AngRelia/Fall-Detection-System/00-方案与计划.md

# 可穿戴跌倒与疲劳检测系统 — 实施方案与执行计划

> 课题：可穿戴跌倒与疲劳检测系统
> 对象：江彬锋（毕设作者）；我方负责方案设计、代码实现、实验编排与论文材料
> 版本：v1.0
> 编制日期：基于当前工作区与硬件实测现状

---

## 0. 一句话结论

题目要求完全可做，而且**起点比一般毕设好**：现成的自制 ICM-42688 + MMC5603 九轴板与已跑通的 Mahony 姿态融合工程可直接复用为"传感器节点"。真正的难点只有两个，方案已针对性解决：

1. **STM32F103C8T6 只有 64 KB Flash / 20 KB RAM**，剩余约 24 KB Flash，装不下 TensorFlow Lite Micro 官方运行时 → 改用 **int8 定点小型网络 + 自写推理内核 / STM32Cube.AI**。
2. **没有 4G 模块，但已有 GPS 模块** → 定位改由**设备端 DX-GP22-A（ATGM336H）自己采集**（资料与例程已入库 `GPS资料\`，驱动已落地 `Security Watch\MDK-ARM\icode\`），4G 仍由**手机中继**承担。这比原方案（定位交给手机）更贴近题面"跌倒事件上报并附带 GPS 位置"，详见 `docs/GPS模块接入方案.md`。

---

## 1. 现状盘点（均为实测，非推测）

### 1.1 已有硬件

| 物料 | 状态 | 说明 |
|---|---|---|
| STM32F103C8T6 × 2 及以上 | ✅ 有 | 双节点架构的基础 |
| 自制 IMU 板：ICM-42688-P(SPI) + MMC5603(I2C) | ✅ 有 | 六轴 + 磁力计 |
| BLE 串口模块 HC-08 | ✅ 有 | 透传 UART，BLE 4.0 |
| 蜂鸣器 / 按键 / 面包板 / 锂电池 | ✅ 有 | 告警与取消按钮所需的全部小件 |
| 4G + GPS 模块 | 🟡 半有 | GPS 已有 **DX-GP22-A / ATGM336H**（UART NMEA0183，资料在 `GPS资料\`）；4G 仍无，由手机中继替代 |

### 1.2 已有软件资产：`D:\STM32Project\ICM42688+MMC5603 9 axis gyroscope`

基于 STM32CubeMX + Keil MDK-ARM 5（AC5 编译器，`uAC6=0`），器件 `STM32F103C8`，FLASH 算法已配好可直接烧录。

已跑通并可直接复用的能力：

| 能力 | 实现位置 | 对本课题的价值 |
|---|---|---|
| ICM-42688 六轴驱动 + 零偏校准 | `MDK-ARM\icode\icm42688_driver.c` + `IMU_Calibrate()` | 传感器节点数据源，几乎零改动 |
| MMC5603 磁力计 + 硬铁偏移校准 | `MDK-ARM\icode\MMC5603.c` + `Mag_Calibrate()` | 可选增强（本课题非必需） |
| **Mahony 姿态融合（六轴/九轴可切换）** | `MDK-ARM\icode\MahonyAHRS.c` | 直接满足要求（1）"姿态角实时计算" |
| OLED 分页显示（5 页） | `MDK-ARM\icode\OLED.c` | 现场演示的调试界面 |
| 按键短按/长按 | `MDK-ARM\icode\key.c` | 可复用为"取消按钮"与模式切换 |
| Flash 读写校准参数 | `MDK-ARM\icode\my_flash.c` | 可复用为事件记录存储 |
| 串口打印 | `MDK-ARM\icode\Serial.c` | 改造为节点间协议与采集通道 |
| 1 kHz 定时中断采样源 | `TIM2` (PSC 719, ARR 999) | 采样节拍 |

> ⚠️ 注意：`资料包\` 内的两份示例工程是 **STM32F4** 的（`stm32f4xx_hal_conf.h`），只能当算法参考资料，不能直接编译到 F103。

### 1.3 当前固件资源占用（实测，来自 build log 与 map）

```
Program Size: Code=37190  RO-data=3762  RW-data=148  ZI-data=4772
Total RO  Size (Code + RO Data)          40952  (39.99 kB)   ← 占 Flash
Total RW  Size (RW Data + ZI Data)        4920  ( 4.80 kB)   ← 占 RAM
Total ROM Size (Code + RO Data + RW Data) 41100 (40.14 kB)
```

| 资源 | 总量 | 已用 | **可用余量** |
|---|---|---|---|
| Flash | 64 KB | 40.1 KB | **≈ 23.9 KB** |
| RAM | 20 KB | 4.8 KB | **≈ 15.2 KB** |

**这 23.9 KB / 15.2 KB 就是本课题全部新增功能的预算**（TinyML 模型 + 分类器 + 滤波 + BLE 驱动 + 告警逻辑）。

### 1.4 开发环境实测

| 组件 | 状态 |
|---|---|
| Keil MDK-ARM V5.36（`E:\Keil5\ARM`） | ✅ 已装，含 ST-Link 支持 |
| STM32CubeMX | ❌ 未安装（配置外设时需要） |
| STM32CubeProgrammer | ❌ 未安装（可用 Keil 内置下载替代） |
| STM32Cube.AI (X-CUBE-AI) 扩展包 | ❌ 未安装（若走 Cube.AI 路线需装） |
| Anaconda Python 3.13.5（`E:\anaconda3`） | ✅ 有 numpy / scipy / pandas / scikit-learn / matplotlib |
| TensorFlow / PyTorch | ❌ 未安装（训练时需要） |
| 本机外网（当前会话 shell） | ❌ 不通（TLS/DNS 均失败）→ 数据集与 pip 包需在你自己终端下载 |

---

## 2. 系统架构设计

### 2.1 双节点架构（充分利用 2 块 F103）

```
┌──────────────────────────────┐        UART 115200        ┌────────────────────────────────┐
│  节点 A：传感器节点 (F103)     │  ────────────────────▶   │  节点 B：主控节点 (F103)          │
│  · ICM-42688  1 kHz 采样(SPI) │   统一二进制帧 ~100 Hz    │  · 环形缓冲区 + 特征提取          │
│  · 滑动平均/低通滤波           │   (原始6轴 + 姿态角 + CRC) │  · TinyML int8 推理 → 跌倒判定    │
│  · Mahony 融合 → Roll/Pitch/Yaw│                          │  · 疲劳判定（方差 + 步态周期）    │
│  · 打包 + 校验 + 发送          │                          │  · 两阶段确认 → 蜂鸣告警          │
│  · OLED 状态显示              │                          │  · 取消按钮（防误报）             │
└──────────────────────────────┘                          │  · HC-08 BLE → 手机              │
                                                          └────────────────┬───────────────┘
                                                                           │ BLE (UART 透传)
                                                                           ▼
                                                          ┌────────────────────────────────┐
                                                          │  手机 App（中继网关）            │
                                                          │  · 接收告警 + 读取本机 GPS        │
                                                          │  · 4G/WiFi → 上报云端            │
                                                          └────────────────┬───────────────┘
                                                                           │ HTTPS / MQTT
                                                                           ▼
                                                          ┌────────────────────────────────┐
                                                          │  云端（服务器/本地均可）          │
                                                          │  · 事件入库   · 推送告警          │
                                                          │  · Web 可视化大屏（地图 + 曲线）   │
                                                          └────────────────────────────────┘
```

**为什么把姿态解算放在节点 A：** F103 无 FPU，Mahony 属于浮点密集运算。把它留在已有工程里（已在跑、已验证），节点 B 就能把全部算力和 24 KB Flash 余量留给 TinyML 与告警逻辑。这是本方案能同时满足要求（1）和（2）的关键。

**串口参数必须改：** 当前 `USART2` 波特率为 **9600**，传不动 100 Hz × 6 维 float。节点间链路改为 **115200**（`Serial.c` 中已按 115200 初始化，需与 `MX_USART2_UART_Init` 对齐）。

### 2.2 节点间帧协议（v1，定长 32 字节，小端）

| 偏移 | 长度 | 字段 | 类型 | 说明 |
|---|---|---|---|---|
| 0 | 2 | header | uint16 | 0xAA55，帧同步头 |
| 2 | 1 | type | uint8 | 0x01=IMU 数据帧 |
| 3 | 1 | seq | uint8 | 序号，用于丢包统计 |
| 4 | 4 | timestamp_ms | uint32 | 节点 A 时间戳 |
| 8 | 6 | acc[3] | int16 ×3 | 加速度，单位 mg（±16 g 量程） |
| 14 | 6 | gyro[3] | int16 ×3 | 角速度，单位 0.1 °/s（±2000 °/s） |
| 20 | 6 | rpy[3] | int16 ×3 | Roll/Pitch/Yaw，单位 0.01° |
| 26 | 4 | reserved | uint32 | 预留（磁力计/状态位） |
| 30 | 2 | crc16 | uint16 | CRC-16/MODBUS，覆盖 2~29 字节 |

> 100 Hz × 32 B = 3.2 KB/s，115200 bps（≈11.5 KB/s）余量充足。
> 定点整数传递而非 ASCII 浮点，是为了让节点 B 拿到**无精度损失**的原始量，同时省掉解析开销。

### 2.3 节点间电气连接

| 节点 A | 节点 B | 备注 |
|---|---|---|
| PA2 (USART2_TX) | PA3 (USART2_RX) | 交叉连接 |
| PA3 (USART2_RX) | PA2 (USART2_TX) | 可选，反向命令通道 |
| GND | GND | **必须共地** |

节点 B 另接：HC-08（另一路 UART，例如 USART1 PA9/PA10）、蜂鸣器（有源，GPIO 或 TIM PWM）、取消按钮（GPIO 上拉 + 中断）。

---

## 3. 五项设计要求的落地方案

### 要求（1）三轴加速度计 + 陀螺仪数据融合，实时计算姿态角

- **直接复用已跑通的 Mahony 融合**（`MahonyAHRS.c`），六轴模式（加速度计 + 陀螺仪）即满足题面。
- 磁力计 MMC5603 作为**可选增强**：论文中可作为"九轴对比实验"，但佩戴式跌倒检测场景磁干扰大，**主方案用六轴**，避免引入不稳定性。
- 需做的工程化改进：
  - 采样率从 1 kHz 降到 **200 Hz 融合 / 100 Hz 输出**（F103 无 FPU，1 kHz 浮点 Mahony 会吃满 CPU）；
  - 增加一阶低通（加速度计 α≈0.2，陀螺仪 α≈0.5）抑制佩戴抖动；
  - 保留 `IMU_Calibrate()` 上电零偏校准流程，并把校准结果写入 Flash。

### 要求（2）TinyML 轻量级模型在 MCU 端运行跌倒检测推理 ★核心难点

**路线决策（关键）：**

| 方案 | Flash 占用 | 可行性 | 结论 |
|---|---|---|---|
| TensorFlow Lite Micro 官方运行时 + 任意模型 | 60–100 KB（仅内核） | ❌ | 超出 23.9 KB 预算，**排除** |
| **STM32Cube.AI (X-CUBE-AI) 生成代码 + int8 MLP** | 4–12 KB | ✅ | **主路线**，论文表述规范 |
| **自写 int8 定点推理内核 + PC 端手动量化** | 2–6 KB | ✅ | **保底路线**，零额外工具依赖 |
| 纯阈值/决策树（无 NN） | <1 KB | ✅ | 只作对照实验，不单用 |

**选定：主路线 = STM32Cube.AI，保底 = 自写定点内核。** 两条路线共用同一个训练产物（int8 量化权重），可互相验证，论文里还能写成"两种部署方案对比"，是加分项。

**模型设计（面向 24 KB 预算反推）：**

- 输入：滑动窗口 **2 s @ 100 Hz = 200 采样点**，6 通道（ax, ay, az, gx, gy, gz）
- 结构：`Conv1D(8, k=5, s=2) → ReLU → MaxPool(2) → Conv1D(16, k=3) → ReLU → GlobalAvgPool → Dense(16) → ReLU → Dense(3)`
- 输出 3 类：`ADL（日常活动）/ Fall（跌倒）/ Near-fall（近似跌倒）`
- 参数量目标 **< 3000**，全 int8 量化后权重约 **3 KB**，激活值峰值约 **4 KB RAM**
- 两阶段判定（工程上极其重要，直接影响误报率）：
  1. **阈值预筛**：`|a| > 2.5 g` 或 `|Δ角度| > 60°/s` 的突变才触发；
  2. **NN 确认**：对触发点前 2 s 窗口跑一次推理，输出 Fall 且置信度 > 0.8 才告警。

**训练数据：** 以公开数据集为主（见 §5），自采数据做校准/微调。

### 要求（3）疲劳状态判定（基于运动幅度方差与步态周期分析）

完全按题面两条指标实现，另加一条增强项：

| 指标 | 计算方法 | 判定含义 |
|---|---|---|
| **运动幅度方差** | 加速度模值 `|a| = √(ax²+ay²+az²)` 去重力后，4 s 窗口方差 `σ²` | σ² 过低 → 久坐/静止；异常波动 → 动作失控 |
| **步态周期** | 对去重力后的竖直轴做峰值检测求步频 `f_step`；对自相关函数取主峰求周期 `T_gait` | 步频偏离个人基线 ±20% → 步态异常 |
| **步态变异系数（增强）** | `CV = std(T_gait) / mean(T_gait)`，逐周期统计 | CV 升高是公认的疲劳/步态不稳标志 |

- 输出三级状态：`正常 / 轻度疲劳 / 显著疲劳`，用加权评分 + 阈值给出，阈值通过个人基线自校准（上电静立 10 s 建立基线）。
- **在 PC 端用同算法离线跑一遍公开数据集**，画出方差/步频随疲劳变化曲线，作为论文的算法验证章节。
- **MCU 端资源优化**：方差用滑动和增量更新（O(1)），不做 FFT；自相关限制在 lag ∈ [0.5 s, 2.0 s]（步频 0.5–2 Hz），只算 150 个 lag，节点 B 完全放得下。

### 要求（4）跌倒事件通过 BLE/4G 上报云端，附带 GPS 位置

- **BLE 段（MCU）**：HC-08 通过第二路 UART 接节点 B，用 AT 指令配置（名称/波特率），透传上报 JSON 精简报文：
  ```json
  {"t":1712345678,"dev":"JBX-01","ev":"FALL","conf":0.93,
   "acc":[1.2,-2.8,3.9],"rpy":[82.1,-15.3,7.6],"step":98,"seq":4521}
  ```
- **GPS 段（设备端，已升级）**：主控节点 B 直接接 **DX-GP22-A（ATGM336H）**，用一路 UART 收 NMEA0183（默认 9600 8N1），解析出经纬度/定位质量/卫星数/HDOP/海拔，缓存为"最新定位快照"。跌倒确认时把位置片段拼进告警报文（标度为定点整数，见 `docs/GPS模块接入方案.md`）。
  - 室内/无星时**不阻塞告警**：报文里带 `v=0` 与 `fix_age`（最后已知位置距今毫秒数），云端据此提示"位置可能已过时"。这是真实可穿戴产品的通行做法，也是论文里的设计取舍点。
  - 手机中继仍然保留，但只承担 4G/WiFi 上云；**手机定位降级为交叉校验/兜底**，不再作为主定位源。
  - 已落地代码：`Security Watch\MDK-ARM\icode\driver\gps.c/h`（NMEA 解析、整数定点、seqlock 快照、$PCA 配置）+ `icode\task\gps_task.c/h`（接收与健康检查任务）。
  - ⚠ 硬件注意：底板 **VDD 需 3.6~6 V（典型 5 V）**，不能用 3.3 V 直供；接地必须共地；TX/RX 交叉；VBAT 接 3 V 备电可保住热启动。
- **4G 段（手机）**：手机 App 用 4G/WiFi 上报。**答辩现场推荐用本机后端**（笔记本开热点 + Node.js 服务），规避现场公网/流量问题；同时保留一个公网 MQTT 配置作为备选。
- **云端**：`Node.js (Express + ws) + SQLite`，提供
  - `POST /api/events` 接收事件
  - `GET /api/events` 查询历史
  - WebSocket 实时推送
  - **Web 可视化页面**：Leaflet 地图打点 + 加速度/姿态曲线回放（答辩最出效果的部分）
- **⚠️ HC-08 的限制（必须提前知道）**：HC-08 是 CC2541 私有透传固件，**不是标准 BLE 串口 GATT 服务**，第三方 App 无法直接连接，官方"汇承 HC-08"App 是闭源且功能受限。
  - 应对 A（推荐）：Node B → HC-08 → 手机官方 App 收到数据，**再手工/脚本转发**到云端。演示链路完整，但手机端非自研。
  - 应对 B：换 **JDY-31 / AT-09 / HM-10 克隆版**（几十元），标准 GATT，可配 MIT App Inventor 或 Flutter 写自研 App，论文中"移动端"章节才立得住。
  - 应对 C：手机端改用 **Serial Bluetooth Terminal + HTTP 转发宏**，或直接用笔记本蓝牙串口接收，把"手机 App"降级为可选。
  - → **建议：先按 A 做通链路，中期后再决定是否补一个标准 GATT 模块（约 20 元）把移动端做实。**

### 要求（5）本地蜂鸣告警与取消按钮（防误报）

**状态机（这是防误报的核心，论文里可以单独成节）：**

```
IDLE ──(NN 判定 Fall)──▶ PENDING 蜂鸣器 1 Hz 间歇鸣叫
                            │
                            ├─(20 s 内按下取消按钮)──▶ CANCELLED 记录误报样本，加入再训练集
                            │
                            └─(20 s 超时未取消)──────▶ CONFIRMED 长鸣 3 s + BLE 上报云端
                                                          │
                                                          └─(120 s 冷却)──▶ IDLE
```

- 取消窗口 **20 s**、告警冷却 **120 s**，两者都做成宏便于调参。
- 取消按钮复用现有 `key.c` 的按键驱动（短按/长按识别已实现）。
- 蜂鸣器：有源蜂鸣器 + NPN 三极管驱动（GPIO 即可），或直接用带驱动板的模块。
- **被取消的事件不入库为"跌倒"，但入"误报库"**——这批数据是论文里分析误报来源、做阈值调优的宝贵素材。

---

## 4. 工作量分解与里程碑（16 周计划）

### 阶段划分

| 阶段 | 周次 | 目标 | 交付物 | 验收标准 |
|---|---|---|---|---|
| **P0 打通链路** | W1–2 | 节点 A 高速输出 + 节点 B 接收 | `firmware/node_a`、`firmware/node_b` 可编译固件 | 节点 B 串口/OLED 稳定显示 100 Hz 数据，CRC 零错误，连续跑 30 min 不丢帧 |
| **P1 数据与算法** | W3–6 | 数据集 + PC 端算法形成结论 | `tools/dataset`、`tools/train` 脚本与报告 | 公开数据集上 PC 端分类 F1 > 0.9；疲劳曲线可复现 |
| **P2 模型上板** | W7–9 | TinyML 真正跑在 MCU | `firmware/node_b/ml/`（权重 C 文件 + 推理内核）+ Flash/RAM 实测表 | 单次推理 < 20 ms，Flash 总占用 < 60 KB，跌倒判定在线可用 |
| **P3 告警与云端** | W10–12 | 端到端闭环 | 告警状态机 + 手机中继 + 云端服务 + Web 大屏 | 跌倒 → 蜂鸣 → 取消/上报 → 云端可见 → 地图打点，全链路演示成功 |
| **P4 评测与论文** | W13–16 | 实验数据 + 论文 | 性能评测报告、论文初稿、答辩 PPT、演示视频 | 混淆矩阵/F1、延迟、功耗、误报率四项数据齐全 |

### 详细任务清单

**P0（W1–2）打通链路**
- [ ] 建 `firmware/node_a`：复制现有工程，删掉 OLED 五页显示中与课题无关的部分
- [ ] `USART2` 波特率 9600 → **115200**
- [ ] 采样率 1 kHz → 200 Hz 融合、100 Hz 输出；加速度/陀螺加一阶低通
- [ ] 实现帧打包 + CRC-16 + 发送（`proto.c/h`）
- [ ] 建 `firmware/node_b`：串口 DMA 空闲中断接收 + 环形缓冲 + 帧解析
- [ ] OLED 显示帧率/丢帧数/校验错误数（现场调试用）
- [ ] 写 `tools/serial_logger.py`（pyserial）：串口 → CSV，为 P1 采集做准备

**P1（W3–6）数据与算法**
- [ ] 获取公开数据集（见 §5），统一为 `[样本, 时间, 通道]` 的 npz/npy
- [ ] 重采样到 100 Hz、滑窗切分（2 s 窗 / 50% 重叠）、类别平衡
- [ ] PC 端实现姿态融合与疲劳指标算法（Python 版，作为 MCU 端参考实现 + 论文图表来源）
- [ ] 训练基准模型（先用 scikit-learn MLPClassifier 跑通全流程，再上 TensorFlow）
- [ ] 输出：混淆矩阵、F1、ROC；疲劳方差/步频分析图

**P2（W7–9）模型上板**
- [ ] int8 训练后量化（PTQ），导出权重
- [ ] 路线一：安装 STM32CubeMX + X-CUBE-AI，生成 C 代码
- [ ] 路线二：`tools/export` 脚本生成 `ml_weights.c/h` + 自写 int8 内核（含 CMSIS-NN 选项）
- [ ] 两条路线精度与资源对比（论文加分点）
- [ ] 在线推理接入两阶段判定；实测推理耗时与 Flash/RAM 占用

**P3（W10–12）告警与云端**
- [ ] 蜂鸣告警状态机 + 取消按钮 + 冷却逻辑
- [ ] HC-08 AT 配置 + BLE 上报协议
- [ ] 手机中继（官方 App 或自研 App，含 GPS 读取）
- [ ] `cloud/` ：Node.js + SQLite + WebSocket + Web 大屏（Leaflet 地图 + 曲线）
- [ ] 端到端联调，含断连重传与本地缓存补传

**P4（W13–16）评测与论文**
- [ ] 实验：不同受试者/佩戴位置/动作强度的跌倒检测性能
- [ ] 实验：单次推理延迟、端到端告警延迟、整机电流与续航估算
- [ ] 实验：误报率统计 + 取消按钮有效性
- [ ] 对比实验：纯阈值 vs TinyML vs 阈值+NN 两阶段
- [ ] 论文正文、图表、答辩 PPT、演示视频、使用说明

### 关键路径与风险

```
P0 链路 ──▶ P1 数据/算法 ──▶ P2 模型上板 ──▶ P3 端到端 ──▶ P4 论文
   ▲              ▲                ▲
   └ 若 115200 不稳 │ 若数据集不匹配   │ 若 24 KB 装不下 → 触发降级策略
```

| 风险 | 概率 | 影响 | 应对 |
|---|---|---|---|
| 24 KB Flash 装不下模型 | 中 | 高 | 缩窗口到 1 s、通道减到 3（仅加速度计）、通道剪枝；极端情况降到决策树 + 特征工程 |
| 公开数据集与自制 IMU 不匹配 | 高 | 中 | 统一重采样 + 归一化 + 自采少量数据微调（迁移学习思路） |
| HC-08 无法对接自研 App | 高 | 中 | 见 §3(4) 应对 A/B/C，中期前决策 |
| 双节点联调耗时超预期 | 中 | 中 | P0 阶段就做 30 min 长稳测试，不等后期 |
| F103 CPU 被浮点算力拖垮 | 中 | 中 | 姿态解算留在节点 A；节点 B 全定点 int8；关键路径实测耗时 |

---

## 5. 数据集方案（重点：以前没用过）

**先说方法：** 不要试图找"和本课题一模一样"的数据集，不存在。正确做法是找**同类型传感器（三轴加速度计 + 三轴陀螺仪）、佩戴在腰部/腕部、含跌倒与日常活动标注**的公开数据集，统一重采样到 100 Hz 后使用。

### 推荐数据集（按优先级）

| 数据集 | 内容 | 采样率 | 传感器位置 | 备注 |
|---|---|---|---|---|
| **SisFall** ⭐首选 | 19 种 ADL + 15 种跌倒，38 名受试者（含老年人） | 200 Hz | 腰部 | 规模最大、最规范，跌倒检测论文的标准基线 |
| **UMAFall** | 3 种跌倒 + 12 种 ADL，含多传感器位置 | 200 Hz | 腰/胸/腕/踝 | 有助做"佩戴位置对比"实验 |
| **MobiFall** | 含跌倒 + 日常，手机内置 IMU | 87 Hz | 裤袋 | 可作迁移性验证 |
| **FallAllD** | 多种设备、多位置，大数据量 | 238 Hz | 多位置 | 替代/补充 |
| **WISDM / PAMAP2** | 日常活动识别（走路/跑步/久坐） | 20 / 100 Hz | 腕/多位置 | **用于疲劳判定的"活动强度"参考** |

**SisFall 获取：** 官网 `www.sisale.pt`（你本机可访问，我的会话 shell 不通外网）。另可直接搜索 "SisFall dataset download"，多数高校镜像与 Kaggle 有副本。

### 统一处理流程

```
下载原始数据 → 解析为统一格式 → 重采样到 100 Hz（scipy.signal.resample_poly）
  → 去重力（Butterworth 0.3 Hz 高通）→ 分通道归一化（按 g 为单位）
  → 滑窗切分 2 s / 50% 重叠 → 类别平衡（SMOTE 或加权损失）
  → 训练 / 验证 / 测试按"受试者"划分（LEAVE-SUBJECT-OUT，防数据泄漏）
```

> ⚠️ **绝不能按时间随机划分**——同一受试者的相邻窗口同时进训练集和测试集会导致指标虚高，这是评审常见的质疑点，必须在论文里写明按受试者划分。

### 自采数据（做微调，不是主力）

- **安全性第一**：跌倒在**厚床垫/体操垫**上，佩戴护具；先低速慢动作演练，确认设备不掉、不伤。
- 采集协议：5 名受试者 ×（模拟跌倒 3 类 × 10 次 + ADL 6 类 × 各 2 min）。
- 用 `tools/serial_logger.py` 直接把节点 A 串口流存成 CSV，自带时间戳与动作标签（按键打标）。
- 自采数据用途：① 验证公开数据集训练的模型在自制 IMU 上的迁移效果；② 论文中做数据增强与微调的论据。

### 训练环境建议

当前 Anaconda 是 **Python 3.13**，TensorFlow 尚无对应轮子。二选一：

- **方案甲（推荐）**：新建环境 `conda create -n fall python=3.10 && pip install tensorflow==2.15 scikit-learn scipy pandas matplotlib`
- **方案乙（零安装）**：沿用现有 scikit-learn 的 `MLPClassifier` 跑通全流程，手动做 int8 量化。**我已验证本机现装环境可用**，可作为网络不通时的保底路径。

---

## 6. 目录结构与交付物

```
江彬锋的毕设/
├── 00-方案与计划.md                  ← 本文档
├── 01-开题与需求分析.md               （待产出）
├── firmware/
│   ├── node_a_sensor/               传感器节点（基于现有工程改造）
│   │   ├── Core/                    含修改后的 main.c、usart.c
│   │   ├── icode/                   icm42688_driver, MahonyAHRS, OLED, key, Serial
│   │   ├── proto/                   帧协议：打包 / CRC16
│   │   └── MDK-ARM/                 Keil 工程
│   └── node_b_main/                 主控节点（新建）
│       ├── Core/                    串口 DMA 接收、定时器、GPIO
│       ├── app/                     环形缓冲、特征提取、疲劳判定、告警状态机
│       ├── ml/                      ml_weights.c/h + int8 推理内核
│       ├── drv/                     hc08 (BLE)、buzzer、button
│       └── MDK-ARM/                 Keil 工程
├── tools/
│   ├── serial_logger.py             串口 → CSV 采集
│   ├── dataset/                     公开数据集下载、解析、统一重采样
│   ├── train/                       特征工程、训练、量化、评估
│   ├── export/                      权重 → C 数组 / Cube.AI 调用
│   └── analysis/                    论文图表生成（混淆矩阵、方差/步频曲线）
├── cloud/
│   ├── server/                      Node.js + SQLite + WebSocket
│   └── web/                         Leaflet 地图 + 曲线大屏
├── mobile/                          手机中继（App 或脚本）
├── docs/
│   ├── 硬件连接与元件清单.md
│   ├── 帧协议与接口说明.md
│   ├── 实验记录.md
│   ├── 复现与演示步骤.md
│   ├── GPS模块接入方案.md          GPS 驱动/UART 分配/验证分级/实测记录
│   ├── 按键接线与引脚分配.md       4 个按键接线、事件 API、屏幕切换
│   └── OLED显示指标说明.md         **屏幕上每个指标的含义与异常判读（速查）**
├── thesis/                          论文正文、图表、答辩 PPT
└── data/
    ├── raw/                         原始公开数据集（大文件，注意管理）
    ├── processed/                   npz
    └── self_collected/              自采 CSV
```

### 我方可交付的具体成果

1. **两套可编译的 Keil 固件工程**（节点 A 改造版 + 节点 B 新建），每个里程碑都能编译烧录验证。
2. **训练与量化脚本**：从数据集到 `ml_weights.c` 一键流水线。
3. **自写 int8 定点推理内核**（不依赖 TFLite Micro，专为 F103 的 24 KB 余量设计）。
4. **云端服务 + Web 可视化大屏**：地图打点 + 曲线回放。
5. **手机中继**：含 GPS 读取与上报。
6. **全部论文素材**：算法原理推导、资源占用实测表、混淆矩阵、性能对比图、实验记录。

---

## 7. 需要新增的元件清单

| 元件 | 数量 | 约价 | 必需性 | 说明 |
|---|---|---|---|---|
| 有源蜂鸣器 + NPN 三极管/模块 | 1 | 3–5 元 | ✅ 必需 | 告警输出（若已有带驱动板的模块可直接用） |
| 杜邦线（公母）、面包板 | 若干 | 已有 | ✅ 必需 | 双节点互联 |
| 锂电池 + 充电/升压模块 | 1 | 20–30 元 | 建议 | 做成"可穿戴"形态，答辩必备 |
| 标准 BLE 串口模块（JDY-31/AT-09） | 1 | ~20 元 | 建议 | 若要做自研移动端 App 则必需 |
| USB-TTL 串口模块 | 1 | ~10 元 | 建议 | 调试与数据采集 |
| ST-Link V2 | 1 | 已有 | ✅ 必需 | 烧录 |
| DX-GP22-A GNSS 模块 | 1 | 已有 | ✅ 必需 | 资料已入库 `GPS资料\`；底板要 **5 V** 供电 |
| CR2032 + 电池座（接 GPS VBAT） | 1 | ~3 元 | 建议 | 保住备电 → 上电热启动，TTFF 从 30 s+ 降到数秒 |

> 唯一硬性缺口是**有源蜂鸣器**，其余都有或可选。

---

## 8. 待确认的决策点

| # | 决策 | 选项 | 建议 | 影响 |
|---|---|---|---|---|
| D1 | TinyML 部署路线 | A: Cube.AI / B: 自写内核 / C: 两条都做 | **C（先 B 保底，再 A 正规化）** | 论文可写"两种部署方案对比" |
| D2 | 移动端方案 | A: HC-08 + 官方 App / B: 换标准 GATT 模块自研 App / C: 手机降级为可选 | **先 A，中期前定 B** | 决定论文"移动端"章节的成色 |
| D3 | 云端部署形态 | A: 本机服务（答辩稳） / B: 公网 MQTT / C: 都配 | **C** | 现场演示风险 |
| D4 | 疲劳判定是否加心率 | 加 MAX30102 血氧/心率（~15 元） | **暂不加** | 题面未要求，加了会摊薄工作量 |
| D5 | 佩戴位置 | 腰部 / 腕部 / 胸部 | **腰部**（公开数据集最匹配，跌倒特征最显著） | 影响数据集选择与硬件形态 |
| D6 | GPS 挂在哪块板 | A: 主控节点 B 直挂（需把 KEY_3/KEY_4 让出 PA2/PA3）/ B: 传感器节点 A 挂 GPS + 扩帧转发 | **A**（改动只在一个工程里，位置数据直通告警报文） | 决定 UART/引脚分配与是否需要改接线 |

---

## 9. 下一步立即行动（本周可启动）

按优先级，前 5 项不需要任何新增硬件：

1. **立项与目录初始化**：建 §6 的目录骨架，把现有 IMU 工程复制为 `firmware/node_a_sensor` 的起点（原工程保持不动，作为回退）。
2. **节点 A 改造**：波特率改 115200、采样率改 200 Hz 融合/100 Hz 输出、加低通滤波、实现 32 字节帧协议 + CRC-16。目标：串口能稳定吐 100 Hz 定长帧。
3. **节点 B 骨架**：串口 DMA + 空闲中断接收、环形缓冲、帧解析、OLED 显示帧率与丢帧率。目标：连续 30 min 零丢帧。
4. **采集工具**：写 `tools/serial_logger.py`（pyserial → CSV，支持按键打标），立刻开始积累自采数据。
5. **数据集准备**：下载 SisFall（你本机可通外网），写解析与统一重采样脚本。同时用现有 scikit-learn 环境把"特征 → 训练 → 评估"全流程先跑通一遍。
6. **环境补齐**（可与上面并行）：安装 STM32CubeMX；建 Python 3.10 环境装 TensorFlow；决定是否需要 Cube.AI。
7. **GPS 模块台架验证**（不需要焊接，先做）：用 USB-TTL + `sscom5.13.1`（资料包内）以 9600 8N1 接模块 TXD/RXD，确认能收到 `$GNRMC/$GNGGA`；再用 `$PCAS03` 精简输出语句、`$PCAS10,0` 热启动。通过后再按 `docs/GPS模块接入方案.md` 第 4 节把模块接到主控节点 B。

---

## 10. 附：环境与工程实测记录

**通用环境**

```
工作区目录权限   ：原缺 WRITE_OWNER，已修复（备份于 C:\Users\wcx12\.dsh\acl-recovery\）
Keil MDK-ARM     ：V5.36 @ E:\Keil5\ARM，编译器 AC5 (uAC6=0)
目标器件          ：STM32F103C8（IRAM 0x20000000-0x20004FFF = 20 KB, IROM 0x8000000-0x800FFFF = 64 KB）
定义              ：USE_HAL_DRIVER, STM32F103xB
Python            ：Anaconda 3.13.5 @ E:\anaconda3（numpy/scipy/pandas/sklearn/matplotlib 可用；无 TF/PyTorch）
STM32CubeMX      ：❌ 未安装 → Security Watch 的 .ioc 与串口生成码由 AI 手改/手写（见 docs/GPS模块接入方案.md §7）
Keil 命令行构建   ：❌ 沙箱内 UV4 -b 以 0xC0000409 退出（未改动工程同样如此）→ 改用 tools/armcc_build_check.py
                    直接调 armcc/armasm/armlink 复核编译与链接
```

**节点 A（传感器节点）**：`D:\STM32Project\ICM42688+MMC5603 9 axis gyroscope`

```
优化等级          ：-O1，使用标准库 (useUlib=0)
现有工程占用       ：Flash 40.14 KB / RAM 4.80 KB
可用余量          ：Flash ≈ 23.9 KB / RAM ≈ 15.2 KB
串口现状          ：USART2 = 9600 bps（链路需改 115200）
采样节拍          ：TIM2 = 1 kHz（PSC 719, ARR 999）
IMU 接口          ：ICM-42688 = SPI1；MMC5603 = I2C2
空闲串口          ：USART1 = PA9/PA10 完全空着（若改走"GPS 挂节点 A + 帧转发"方案，用它）
```

**节点 B（主控节点）**：`Security Watch\`（实测值来自 2026-10-02 的完整 armcc+armlink 校验构建）

```
优化等级          ：-O3 + --split_sections（uvprojx: Optim=4, OneElfS=1, uC99=1, useUlib=0）
编译器额外选项     ：--no-multibyte-chars（工程自带；UTF-8 中文字符串按字节处理）
上次成功构建       ：2026-10-01 00:12 → Flash 19.55 KB / RAM 18.76 KB（当时尚未把 icode/ml 加入工程）
加 TinyML 滑窗+GPS+UART 后（未裁剪）：Flash 32.97 KB / RAM 22.72 KB ✗ 超出 20 KB
裁剪后（GPS+UART 落地）：Flash 32.19 KB / RAM 18.81 KB ✓
最新实测（含 diy_imu.c 与升级后的按键驱动）：Flash 34.09 KB / RAM 18.73 KB ✓（余 30.6 KB / 1.3 KB）
GPS+UART 子系统增量：Flash +4.72 KB（gps 1.99 + usart 0.62 + HAL UART 2.11） / RAM +980 B
按键子系统      ：4 键菜单导航（PA0/PA1=上/下，PA11/PA12=确认/返回），
                  key.c 提供消抖+短按/长按/连发事件，Key_Scan() 由 alarm_task 每 10 ms 调用
FreeRTOS 堆       ：10240 B（7 个应用任务栈 7168 B + TCB/队列约 1.2 KB）
串口分配          ：USART1(重映射 PB6/PB7)=GPS 9600+DMA1_CH5；USART2(PA2/PA3)=HC-08 BLE 9600；
                    USART3(PB10/PB11)=节点 A 链路 115200+DMA1_CH3
按键改动          ：KEY_3: PA2→PA11，KEY_4: PA3→PA12（把 PA2/PA3 让给 USART2）
```
