AngRelia/Fall-Detection-System/docs/OLED显示指标说明.md

# OLED 显示指标说明（节点 B）

> 本文逐个解释节点 B（主控板）OLED 上出现的**每一个指标**：含义、单位、正常范围、异常怎么判读。
> 真源：`Core/Src/freertos.c`（任务/堆）、`MDK-ARM/icode/task/oled_task.c`（绘制）、
> `MDK-ARM/icode/driver/gps.c`（GPS 数据）、`MDK-ARM/icode/driver/key.c`（按键数据）。
> 屏幕规格：128×64，6×8 字体 → **每行 21 字符、共 8 行**，刷新率 10 Hz（100 ms）。

---

## 0. 屏幕总览与切换

`oled_task.c` 顶部一个宏决定显示哪一套界面（编译期切换，重新编译才生效）：

| 宏值 | 界面 | 用途 |
|---|---|---|
| `OLED_SCREEN_IMU　　(0)` | DIY IMU 链路状态页（三页轮换） | 看节点 A 的串口链路与姿态数据 |
| `OLED_SCREEN_KEYTEST (1)` | 按键检测页 | 验证 4 个按键与接线 |
| `OLED_SCREEN_GPS　　(2)` | **GPS 接收页（当前）** | 验证 GPS 接收、解析、定位 |

**GPS 页内翻页**：按板上 **KEY_1（上）= 上一页**、**KEY_2（下）= 下一页**，三页循环；
长按 1 s 后进入连发（每 150 ms 一次），可以快速翻。翻页提示与页码在最后一行 `UP/DN=PAGE n/3`。

**刷新节奏**：屏幕 100 ms 刷一次；GPS 语句 1 Hz（GSV 约 1~3 s 一轮）。
所以**有些数字看着"几秒不变"是正常的**，不是死机；只有 `RX` / `SCAN` 这类累计量应该一直涨。

**单位与格式约定**：所有小数点显示都是**定点**（整数运算，不引 printf）；
`-` 表示"该数据从未收到过"，而不代表 0。

---

## 1. 开机画面（很短，注意抓）

```
OS Loading...          ← 内核起来前的占位提示
FreeHeap: 03072        ← 剩余 FreeRTOS 堆（字节）
```

- **`OS Loading...`**：`MX_FREERTOS_Init()` 在创建任务前画的一行，随即被覆盖。
- **`FreeHeap:`**：`xPortGetFreeHeapSize()`，即**还剩多少堆**给后续 `xTaskCreate` / 队列用。
  - 正常值 **≈ 2000 B**（堆总量 8192 B；7 个应用任务栈 5376 + TCB 672 + 定时器队列 ≈ 120，合计约 6.2 KB）。
  - ⚠ **接近 0 是危险信号**：`xTaskCreate` 会返回失败，而当前 `configASSERT` 是关中断死循环 ——
    表现就是"某个任务完全不运行、屏幕卡住"，且没有任何提示。这一行就是为排查它加的。
  - ⚠ 这一行**只闪现一瞬间**：OLED 任务初始化时会清屏（`OLED_Clear()`）再画 `GPS receiving...`。
    想随时看堆，可切到**按键检测页**（它的最后一行常驻 `HEAP`），或让我在 GPS 页加一个 `SYS` 页。

---

## 2. GPS 页 1/3 —— 链路 + 语句普查

```
GPS LINK      ALIVE
RX    00070392
RMC  00158    GGA  00158
GSV  00214    GSA  00316
OTH  00632    CSE  0000
LAST POS SENT
$GNGGA,073028.00,3011
UP/DN=PAGE 1/3
```

| 字段 | 含义 | 正常 | 异常怎么读 |
|---|---|---|---|
| `ALIVE` | **链路活着**：距最后一次收到字节 < 5 s（`GPS_IsAlive()`，判据 `GPS_GetLastRxAge() ≤ 5000 ms`） | `ALIVE` | `LOST` = 5 s 没收到任何字节。任务会自动 `GPS_Reinit()` 重新武装接收；若一直 `LOST` 且 `RX` 不涨，查 TXD/RXD/共地/供电 |
| `RX` | **累计收到字节数**（8 位十进制） | 持续增长，9600 8N1 下约 400~950 B/s | **停在 0 = 一个字节都没收到**，这是第一判据：先查接线与模块供电（VDD 要 5 V），不要看别的 |
| `RMC` | 累计**通过校验**的 RMC 语句条数 | 约 1 条/s | **恒为 0 = 模块没输出定位语句** → 经纬度不可能出来（`gps_task` 会自动发 `$PCAS03` 修复，最多 3 次） |
| `GGA` | 累计通过校验的 GGA 语句条数 | 约 1 条/s | 同上。经纬度/海拔/HDOP/卫星数都来自 GGA 或 RMC |
| `GSV` | 卫星视图语句条数（可见卫星与信噪比） | 每秒约 1~3 条 | 恒为 0 时 `VW`/`MX` 必然为 0（不是天线坏，而是这类语句没开） |
| `GSA` | 几何精度因子语句条数 | 约 1~2 条/s（每星座 1 条） | 仅供统计，本课题不解算 |
| `OTH` | 其它语句条数（VTG/ZDA/TXT…），**实测主要是 TXT 天线状态提示，占约 43%** | 视模块配置 | 数值很大是正常的（厂家模块反复播报天线状态） |
| `CSE` | 累计**校验和错误**的语句条数 | **0** | 持续增长 = 波特率或电平不对（收到的是噪声）。若 `RX` 涨而 `SEN` 类计数不涨、`CSE` 猛涨，先把波特率改回 9600 |
| `LAST POS SENT` | 下面一行显示的**最近一条 RMC/GGA 原文**（前 21 字符，含前导 `$`） | 形如 `$GNRMC,073028.00,A,301` | 字段解析出任何问题时，**把这行原文发出来**即可定位（注意它**不是**"最近一条任意语句"：实测 GPTXT 会挤占 43%，所以专门留档 RMC/GGA） |
| `UP/DN=PAGE n/3` | 翻页提示 + 当前页码 | 1~3 | 按键不响应则页码不变 |

> 累计量（`RX/RMC/GGA/GSV/GSA/OTH/CSE`）**上电清零、只增不减**；溢出后按显示位宽截断，
> 所以长时间运行后它们不能用来算"速率"（要算速率请取两次读数做差并配时间）。

---

## 3. GPS 页 2/3 —— 卫星与天线

```
GPS SATELLITE
FIX  YES  Q 1
ST   11   used
VW   11   view
MX   39   dBHz
AGE  0000 s
RMC A       GGA 1
UP/DN=PAGE 2/3
```

| 字段 | 含义 | 正常 | 异常怎么读 |
|---|---|---|---|
| `FIX YES/NO` | **定位是否有效**（驱动 `valid` 标志） | `YES` | 判据：**RMC 的 status = A 或 GGA 的 quality > 0**（两者任一成立即有效）。`NO` 时经纬度即使非 0 也不可信 |
| `Q n` | GGA 的**定位质量**字段 | `1`（单点定位） | `0`=无效；`1`=单点；`2`=差分；`3`=PPS；`4`=RTK 固定；`5`=RTK 浮动；`6`=估算/航位推算（丢星时可能出现） |
| `ST nn used` | **参与定位的卫星数**（GGA 第 7 字段，实际用于解算的星数） | ≥ 4（通常 6~12） | 0~3 时无法定位（几何条件不够），会一直 `NO` |
| `VW nn view` | **可见卫星总数**（GSV，**各星座求和**：GPS + 北斗 + GLONASS + 其它） | ≥ `ST`，通常 6~25 | **0 = 射频没收到信号**：天线没接好/坏了，或完全在无窗室内。注意它≥`ST` 才是自洽的（早期版本两星座互相覆盖，出现过"参与 11、可见 6"的矛盾） |
| `MX nn dBHz` | 本轮 GSV 里**最强信噪比 C/N0**（dBHz） | > 35 优秀；25~35 良好 | 15~25 一般（勉强可用）；< 15 或 0 = 信号很弱/没有。**这是判断天线好坏的直接指标**（比 `ANTENNA OPEN` 那条提示可靠得多） |
| `AGE nnnn s` | **距最后一次有效定位的秒数**（`fix_age`） | 0~1（实时定位时） | 进屋/断星后会持续增长。**这正是跌倒报文的 `gps.fix_age`**：它告诉云端"这个位置有多旧"。演示前先在室外定位、再保持供电进屋，位置仍可用且 `AGE` 如实增长 |
| `RMC A/V/-` | RMC 的 **status** 原始字符 | `A`（有效） | `V` = 该帧无效（还没定上）；`-` = **从未收到 RMC** |
| `GGA n/-` | GGA 的 **quality** 原始值 | `1` 或 `2` | `0` = 无效；`-` = 从未收到 GGA |

**关于 `ANTENNA OPEN`**：模块（DX-GP22-A 板载陶瓷天线＝无源）会周期性输出
`$GPTXT,01,01,01,ANTENNA OPEN*25`。技术手册 §2.12.3 明确写着"**用无源天线时模块输出语句均为开路**"——
**这条不代表故障**；判断天线请只看 `VW` 与 `MX`。

---

## 4. GPS 页 3/3 —— 位置

```
GPS POSITION
LAT  30.1875525N
LON 120.8166950E
ALT     12.0 m
HDOP     2.90
SPD      0.0 km/h
UTC  07:30:28
UP/DN=PAGE 3/3
```

| 字段 | 含义 | 单位/格式 | 说明 |
|---|---|---|---|
| `LAT` | **纬度**（WGS-84），末尾 `N`/`S` | 度，7 位小数 | NMEA 原始格式是 `ddmm.mmmm`，驱动换算 `度 = dd + mm/60`（纯整数运算，误差 < 4 mm）。1e-7 度 ≈ 1.1 cm |
| `LON` | **经度**，末尾 `E`/`W` | 度，7 位小数 | 同上 |
| `ALT` | **海拔**（GGA 第 9 字段：天线相对平均海平面高度） | m，1 位小数 | 城市地区几十米量级属正常；数值明显离谱时多半是还没稳定定位 |
| `HDOP` | **水平精度因子**（越小越好） | 无量纲，2 位小数 | < 1 极好；1~2 好；**2~5 一般（常见）**；5~10 差；> 10 很差。它是"卫星几何分布"的质量，与天线信号强弱是两件事 |
| `SPD` | **地面速度**（RMC 速度字段：节 → km/h） | km/h，1 位小数 | 静止时应为 `0.0`；走路约 3~6，跑步约 8~15。可用于跌倒后的活动/静止判断 |
| `UTC` | **UTC 时间**（RMC/GGA 第 1 字段 `hhmmss.ss`） | `hh:mm:ss` | **北京时间 = UTC + 8**。显示 `no time` = 该字段为空（无定位时常见）或还没解析出来 |
| `UP/DN=PAGE 3/3` | 翻页提示 + 页码 | — | — |

**没有任何定位语句时这一页不会给一堆 0 误导你**：`LAT/LON` 会显示 `no RMC/GGA`、`UTC` 显示 `no time`。
（原因：`GPS_GetFix()` 只保证"读到一致快照"，开机 seq=0 时就返回成功，
所以判断"有没有数据"必须用累计语句计数，而不是它是否返回成功。）

---

## 5. 按键检测页（`OLED_SCREEN_SEL = OLED_SCREEN_KEYTEST` 时）

```
KEY TEST              EV U-REP
1 UP   [ ]  N 0000  L 00
2 DOWN [ ]  N 0000  L 00
3 OK   [ ]  N 0000  L 00
4 BACK [ ]  N 0000  L 00
RAW 1 1 1 1  HLD 0000 ms
SCAN 0001234  EVT 0000
HEAP 0003072
```

| 字段 | 含义 | 正常 | 异常怎么读 |
|---|---|---|---|
| `EV` | **最近一次按键事件名**（固定 5 字符） | `UP` / `DOWN` / `OK` / `BACK` / `U-REP` / `D-REP` / `B-LNG`；无事件时 `-----` | `U-REP/D-REP` = 上/下键长按后的连发；`B-LNG` = 返回键长按（**就是取消告警的那个手势**，按住 1 s） |
| 键号 + 键名 | 1=UP(PA0)、2=DOWN(PA1)、3=OK(PA11)、4=BACK(PA12) | — | 与 `docs/按键接线与引脚分配.md` 的接线表一致 |
| `[#]` / `[ ]` | **消抖后**的按住状态 | 按住变 `[#]` | 一直 `[#]` = 引脚被短路到 GND（四脚开关左右两侧被焊桥连起来了） |
| `N nnnn` | 该键**按下次数**（累计） | 按一下加 1 | 一次按动跳多个数 = 抖动/接线松动 |
| `L nn` | 该键**长按次数**（≥ 1 s 记一次） | 长按一次加 1 | 不涨 = 长按判定没触发（或没按够 1 s） |
| `RAW a b c d` | 四路引脚的**实时电平**（`1` = 高 = 松开，`0` = 低 = 按下） | 不按时全 `1`；按住某键该位变 `0` | 不按就有 `0` = 该路被短路/接错；按下不变 `0` = 虚焊或接到了同侧另一只脚 |
| `HLD nnnn ms` | 当前**按住时长**（四个键里最大的那个） | 按住时递增 | 不递增 = 该键电平没变化 |
| `SCAN nnnnnnn` | `Key_Scan()` 调用次数（累计） | **约 100/s 增长** | 不涨 = 扫描任务的调用点没在跑（当前调用者是 `alarm_task`），与接线无关 |
| `EVT nnnn` | 累计**入队事件数** | 随按键增长 | 不涨但 `N` 在涨 = 事件入队/出队有问题 |
| `HEAP nnnnnnn` | 剩余 FreeRTOS 堆（字节） | ≈ 3000 | 接近 0 = 堆不足，任务可能静默创建失败 |

> 这一页读的都是 `key.c` 的**只读自检接口**，不消费事件队列，所以看它不会影响菜单/告警的事件流。

---

## 6. 速查：现象 → 判读

| 现象 | 最可能的原因 | 先做什么 |
|---|---|---|
| `RX` 停在 0 | 没接线 / 供电不对 / 模块没上电 | 查 GPS TXD→PB7、RXD→PB6、共地、**VDD=5 V**（底板要 3.6~6 V） |
| `RX` 涨、`CSE` 猛涨、`GSV/GGA` 不涨 | 波特率或电平不对 | 用 PC + sscom 9600 8N1 直连模块确认；必要时发 `$PCAS01,1` 改回 9600 |
| `RMC`/`GGA` 恒为 0 | 模块输出语句集被改乱 | 等任务自动修复（发 `$PCAS03` 全开）；或 PC 手动发 `$PCAS03,1,1,1,1,1,1,1,1,1,1,,,1,1*02` |
| `VW`/`MX` 为 0 | 射频没收到信号 | 到室外/窗外，天线朝上、别用手或金属遮挡 |
| `VW` 有值、`MX` 20~45，但仍 `FIX NO` | 星数还不够或几何差 | 继续等；看 `ST` 是否 ≥ 4、`HDOP` 是否偏大 |
| `FIX YES` 但 `UTC` 为 `no time` | 时间字段为空或解析异常 | 看第 1 页 `LAST POS SENT` 原文；若有时间却没显示就是解析问题 |
| 经纬度是 0 | 从未收到定位语句 | 看第 1 页 `RMC`/`GGA` 计数与 `LAST POS SENT` |
| 屏幕上出现上一页的残留（页面叠在一起） | **换页未清屏** + 页内变长文本 | 已修复且**四个多页屏全覆盖**：GPS 页、HC-08 页、菜单页（换页时 `OLED_Clear()` 一次）、IMU 页（3 s 轮换时清屏）；页内会变的状态字一律改**定长**写入（`"CONN "`/`"NOT CONN"`、`"OK  "`/`"LOST"` 等）。新增多页屏时**必须照抄这三行**：<br>`static uint8_t s_page_drawn = 0xFFU;`<br>`if (page != s_page_drawn) { OLED_Clear(); s_page_drawn = page; }` |
| 某个任务完全不运行、屏幕卡死 | FreeRTOS 堆不足（`xTaskCreate` 静默失败 + `configASSERT` 死循环） | 看 `HEAP`；用 `python tools\heap_ledger.py` 重算堆账 |

---

## 7. 每个指标的代码来源（便于答辩时讲清"数据从哪来"）

| 指标 | 来源 | 代码位置 |
|---|---|---|
| `RX` | 环形缓冲累计字节 | `gps.c` `GPS_GetRxBytes()` |
| `RMC/GGA/GSV/GSA/OTH` | 语句类型计数 | `gps.c` `GPS_GetTypeCount()` |
| `CSE` | 校验和失败计数 | `gps.c` `GPS_GetCsumErrCount()` |
| `LAST POS SENT` | 最近一条 RMC/GGA 原文留档 | `gps.c` `GPS_GetLastPosSentence()` |
| `FIX/Q/ST/HDOP/ALT/SPD/UTC/lat/lon` | RMC/GGA/GSV 解析后的快照（seqlock 保护） | `gps.c` `GPS_GetFix()` |
| `VW` / `MX` | GSV：各星座可见数求和 / 本轮最强信噪比 | `gps.c` `GPS_ParseGSV()` |
| `AGE` | `HAL_GetTick() - stamp_ms` | `oled_task.c`（用 `HAL_GetTick`，与 `gps.c` 同一时基） |
| 按键页各量 | 按键驱动自检接口 | `key.c` `Key_GetRawMask/...` |
| `HEAP` | `xPortGetFreeHeapSize()` | `freertos.c` / `oled_task.c` |
