AngRelia/Fall-Detection-System/Security Watch/Core/Src/main.c

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
/* Includes ------------------------------------------------------------------*/
#include "main.h"
#include "diy_imu.h"      /* USART3: DIY IMU(节点A) 数据链 */
#include "cmsis_os.h"
#include "adc.h"
#include "dma.h"
#include "rtc.h"
#include "tim.h"
#include "gpio.h"
#include "usart.h"

/* USER CODE BEGIN Includes */
#include "OLED.h"
#include "delay.h"
#include "gps.h"
#include "hc08.h"

/* USER CODE END Includes */


void SystemClock_Config(void);
void MX_FREERTOS_Init(void);
/* USER CODE BEGIN 0 */
RTC_DateTypeDef sDate;
RTC_TimeTypeDef sTime;
/* USER CODE END 0 */

/**
  * @brief  The application entry point.
  * @retval int
  */
int main(void)
{

  /* MCU Configuration--------------------------------------------------------*/

  /* Reset of all peripherals, Initializes the Flash interface and the Systick. */
  HAL_Init();

  /* Configure the system clock */
  SystemClock_Config();

  /* Initialize all configured peripherals */
  MX_GPIO_Init();
  MX_DMA_Init();
  MX_TIM2_Init();
  MX_RTC_Init();
  MX_TIM3_Init();
  MX_ADC1_Init();
  MX_TIM1_Init();
  MX_USART1_UART_Init();
  MX_USART2_UART_Init();
  MX_USART3_UART_Init();
  /* USER CODE BEGIN 2 */
	// 检查备份寄存器 DR1 的值是否为 0x32F2
	if (HAL_RTCEx_BKUPRead(&hrtc, RTC_BKP_DR1) != 0x32F2)
	{
	  // 1. 设置日期 (例如：2026年3月6日，星期五)
	  sDate.Year = 26;
	  sDate.Month = RTC_MONTH_MARCH;
	  sDate.Date = 6;
	  sDate.WeekDay = RTC_WEEKDAY_FRIDAY;
	  HAL_RTC_SetDate(&hrtc, &sDate, RTC_FORMAT_BIN);

	  // 2. 设置时间 (例如：14点30分00秒)
	  sTime.Hours = 14;
	  sTime.Minutes = 30;
	  sTime.Seconds = 0;
	  HAL_RTC_SetTime(&hrtc, &sTime, RTC_FORMAT_BIN);

	  // 3. 将 0x32F2 写入备份寄存器，下次重启就不会再重置时间了
	  HAL_RTCEx_BKUPWrite(&hrtc, RTC_BKP_DR1, 0x32F2);
	}
  /* USER CODE END 2 */

  /* Init scheduler */
  osKernelInitialize();  /* Call init function for freertos objects (in cmsis_os2.c) */
  MX_FREERTOS_Init();

  /* Start scheduler */
  osKernelStart();

  /* We should never get here as control is now taken by the scheduler */

  /* Infinite loop */
  /* USER CODE BEGIN WHILE */
  while (1)
  {

	
    /* USER CODE END WHILE */

    /* USER CODE BEGIN 3 */
  }
  /* USER CODE END 3 */
}

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
/* USER CODE BEGIN 4 */

/* 串口接收事件转发：GPS 驱动靠它拿到 NMEA 数据（其它串口会被驱动内部过滤掉） */
void HAL_UARTEx_RxEventCallback(UART_HandleTypeDef *huart, uint16_t Size)
{
  /* USART3: 节点A (DIY IMU 板) 的 32 字节数据帧 */
  if (huart->Instance == USART3)
  {
    DIY_IMU_RxEventCallback(huart, Size);
    return;
  }

  /* USART1: GNSS 的 NMEA 语句流 */

  if (huart->Instance == USART2)
  {
    HC08_RxEventCallback(huart, Size);
    return;
  }


  GPS_RxEventCallback(huart, Size);
}


/* USER CODE END 4 */
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
