AngRelia/Fall-Detection-System/Security Watch/Security Watch.ioc

Mcu.UserName=STM32F103C8Tx
PA0-WKUP.GPIO_Label=KEY_1
PA0-WKUP.Signal=GPIO_Input
PA1.GPIO_Label=KEY_2
PA1.Signal=GPIO_Input
PA10.Signal=S_TIM1_CH3
PA11.GPIO_Label=KEY_3
PA11.Signal=GPIO_Input
PA12.GPIO_Label=KEY_4
PA12.Signal=GPIO_Input
PA13.Signal=SYS_JTMS-SWDIO
PA14.Signal=SYS_JTCK-SWCLK
PA15.Signal=S_TIM2_CH1_ETR
PA2.Signal=USART2_TX
PA3.Signal=USART2_RX
PA4.Signal=ADCx_IN4
PA5.Signal=ADCx_IN5
PA6.Signal=S_TIM3_CH1
PA7.Signal=S_TIM3_CH2
PB0.Signal=S_TIM3_CH3
PB1.Signal=S_TIM3_CH4
PB10.Signal=USART3_TX
PB11.Signal=USART3_RX
PB12.GPIO_Label=Encoder_button
PB12.Signal=GPIO_Input
PB13.GPIO_Label=DHT11
PB13.Signal=GPIO_Output
PB14.GPIO_Label=BEEP
PB14.Signal=GPIO_Output
PB15.GPIO_Label=HC08_STATE
PB15.Signal=GPIO_Input
PB3.Signal=S_TIM2_CH2
PB6.Signal=USART1_TX
PB7.Signal=USART1_RX
PB8.GPIO_Label=OLED_SCL
PB8.Signal=GPIO_Output
PB9.GPIO_Label=OLED_SDA
PB9.Signal=GPIO_Output
PC14-OSC32_IN.Signal=RCC_OSC32_IN
PC15-OSC32_OUT.Signal=RCC_OSC32_OUT
PD0-OSC_IN.Signal=RCC_OSC_IN
PD1-OSC_OUT.Signal=RCC_OSC_OUT
