AngRelia/Fall-Detection-System/Security Watch/Core/Inc/main.h

#define KEY_1_Pin GPIO_PIN_0
#define KEY_1_GPIO_Port GPIOA
#define KEY_2_Pin GPIO_PIN_1
#define KEY_2_GPIO_Port GPIOA
#define KEY_3_Pin GPIO_PIN_11
#define KEY_3_GPIO_Port GPIOA
#define KEY_4_Pin GPIO_PIN_12
#define KEY_4_GPIO_Port GPIOA
#define Encoder_button_Pin GPIO_PIN_12
#define Encoder_button_GPIO_Port GPIOB
#define DHT11_Pin GPIO_PIN_13
#define DHT11_GPIO_Port GPIOB
#define BEEP_Pin GPIO_PIN_14
#define BEEP_GPIO_Port GPIOB
#define OLED_SCL_Pin GPIO_PIN_8
#define OLED_SCL_GPIO_Port GPIOB
#define OLED_SDA_Pin GPIO_PIN_9
#define OLED_SDA_GPIO_Port GPIOB
#define HC08_STATE_Pin GPIO_PIN_15
#define HC08_STATE_GPIO_Port GPIOB
