AngRelia/Fall-Detection-System/Security Watch/MDK-ARM/icode/task/menu_task.c

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

/* Includes ------------------------------------------------------------------*/
#include "menu_task.h"
#include "key.h"
#include "imu_recv_task.h"
#include "diy_imu.h"
#include "gps.h"
#include "hc08.h"
#include "ble_task.h"
#include <string.h>

#define MENU_TASK_PERIOD_MS     20U     /* 20 ms：按键响应即时，汇总开销极小 */
#define MENU_LAST_LINE_LEN      12U     /* 只在屏幕上显示这么多字符 */

TaskHandle_t MenuTaskHandle = NULL;

/* 双缓冲：写者填 [1-idx]，填完原子翻转 idx；读者拷 [idx]。
   idx 是 8 位，写入是单指令，天然原子 ✓ */
static Menu_View_t       s_view[2];
static volatile uint8_t  s_view_idx = 0U;
static uint8_t           s_page = 0U;

void        Menu_Task_Entry(void *argument);
static void Menu_Collect(Menu_View_t *v);

/* USER CODE BEGIN Application */

void Menu_Task_Init(osPriority_t prio, uint32_t stack)
{
  BaseType_t ret = xTaskCreate(Menu_Task_Entry,
                               "MENU",
                               (configSTACK_DEPTH_TYPE)stack,
                               NULL,
                               (UBaseType_t)prio,
                               &MenuTaskHandle);
  /* 堆不足时 xTaskCreate 返回 pdFAIL，任务会静默不运行，必须断言拦住 */
  configASSERT(ret == pdPASS);
}

void Menu_GetView(Menu_View_t *out)
{
  if (out == NULL)
  {
    return;
  }
  /* 拷贝"当前这一份"：写者此刻正在填另一份，所以不会读到写一半的数据 */
  (void)memcpy(out, &s_view[s_view_idx], sizeof(Menu_View_t));
}

/* ---------------------------------------------------------------------------
 * 汇总各子系统状态（全部是只读快照接口）
 * ------------------------------------------------------------------------- */
static void Menu_Collect(Menu_View_t *v)
{
  IMU_Recv_Snapshot_t imu;
  DIY_IMU_Stats_t     imu_st;     /* 直接读驱动的只读统计（含 rx_bytes），
                                     不去改 imu_recv_task（那条链路已跑通，不动它） */
  GPS_Fix_t           fix;
  uint32_t            txok = 0U, txdrop = 0U;

  (void)memset(v, 0, sizeof(Menu_View_t));
  v->page = s_page;

  /* ---- 节点 A：IMU 链路 ---- */
  IMU_Recv_GetSnapshot(&imu);
  v->a_rate = imu.frame_rate;
  v->a_lost = imu.link_lost;
  v->a_ok   = imu.frames_ok;
  v->a_crc  = imu.crc_err;
  v->a_drop = imu.seq_drop;
  v->a_rsy  = imu.resync;
  v->a_rovr = imu.ring_overrun;
  (void)memset(&imu_st, 0, sizeof(imu_st));
  DIY_IMU_GetStats(&imu_st);
  v->a_rxb  = imu_st.rx_bytes;

  /* ---- GPS ---- */
  v->g_alive = GPS_IsAlive(HAL_GetTick()) ? 1U : 0U;
  v->g_rx    = GPS_GetRxBytes();
  v->g_sen   = GPS_GetSentenceCount();
  v->g_cse   = GPS_GetCsumErrCount();
  if (GPS_GetFix(&fix) != 0U)
  {
    v->g_fix    = fix.valid;
    v->g_q      = fix.quality;
    v->g_st     = fix.sats;
    v->g_vw     = fix.sats_view;
    v->g_mx     = fix.snr_max;
    v->g_lat_e7 = fix.lat_e7;
    v->g_lon_e7 = fix.lon_e7;
  }

  /* ---- BLE / HC-08 ---- */
  v->b_conn  = HC08_IsConnected();
  v->b_txb   = HC08_GetTxBytes();
  v->b_rxb   = HC08_GetRxBytes();
  v->b_atok  = HC08_GetAtOkCount();
  v->b_aterr = HC08_GetAtErrCount();
  BLE_GetStats(&txok, &txdrop);
  v->b_send  = txok;
  v->b_drop  = txdrop;
  (void)HC08_GetLastLine(v->b_last, MENU_LAST_LINE_LEN);

  /* ---- 系统 ---- */
  v->heap     = (uint32_t)xPortGetFreeHeapSize();
  v->uptime_s = (uint32_t)(HAL_GetTick() / 1000U);
}

/* ---------------------------------------------------------------------------
 * 任务入口
 * ------------------------------------------------------------------------- */
void Menu_Task_Entry(void *argument)
{
  Key_Event_t nav;
  uint8_t     next;

  (void)argument;

  /* 初始化两份缓冲，避免上电瞬间读到未初始化内容 */
  (void)memset(&s_view[0], 0, sizeof(Menu_View_t));
  (void)memset(&s_view[1], 0, sizeof(Menu_View_t));

  for (;;)
  {
    /* ---- 1) 翻页：上=上一页，下=下一页，循环（含长按连发）---- */
    nav = Key_TakeNav();
    if ((nav == KEY_EVENT_UP) || (nav == KEY_EVENT_UP_REPEAT))
    {
      s_page = (uint8_t)((s_page + (MENU_PAGE_NUM - 1U)) % MENU_PAGE_NUM);
    }
    else if ((nav == KEY_EVENT_DOWN) || (nav == KEY_EVENT_DOWN_REPEAT))
    {
      s_page = (uint8_t)((s_page + 1U) % MENU_PAGE_NUM);
    }

    /* ---- 2) 汇总到"另一份"缓冲，然后原子翻转 ---- */
    next = (uint8_t)(s_view_idx ^ 1U);
    Menu_Collect(&s_view[next]);
    s_view_idx = next;

    vTaskDelay(pdMS_TO_TICKS(MENU_TASK_PERIOD_MS));
  }
}

/* USER CODE END Application */
