AngRelia/Fall-Detection-System/Security Watch/MDK-ARM/icode/task/fatigue_task.c

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
/* Includes ------------------------------------------------------------------*/
#include "fatigue_task.h"
#include "cmsis_os.h"
#include "queue.h"

/* USER CODE BEGIN PTD */
/* 疲劳等级枚举建议：
 *   typedef enum { FATIGUE_NORMAL = 0, FATIGUE_MILD, FATIGUE_SEVERE } Fatigue_Level_t;
 */
/* USER CODE END PTD */

/* USER CODE BEGIN PD */
/* 方差窗口：4 s @ 100 Hz = 400 采样 */
/* #define FATIGUE_VAR_WINDOW      400 */
/* 步频搜索范围 */
/* #define STEP_FREQ_MIN_HZ        0.5f */
/* #define STEP_FREQ_MAX_HZ        2.0f */
/* 基线校准时长（ms） */
/* #define FATIGUE_BASELINE_MS     10000 */
/* USER CODE END PD */

/* USER CODE BEGIN Variables */
/* 任务句柄（由 Fatigue_Task_Init 创建后赋值） */
TaskHandle_t FatigueTaskHandle = NULL;
/* 建议保存：滑动和 sum_a / sum_a2、个人基线 baseline_var / baseline_step_hz */
/* USER CODE END Variables */

/* USER CODE BEGIN FunctionPrototypes */
/* 任务入口：xTaskCreate 需要在本文件内先见到声明 */
void Fatigue_Task_Entry(void *argument);
/* USER CODE END FunctionPrototypes */

/* USER CODE BEGIN Application */

/* ---------------------------------------------------------------------------
 * 任务创建：优先级与栈大小由 freertos.c 统一传入
 * ------------------------------------------------------------------------- */
void Fatigue_Task_Init(osPriority_t prio, uint32_t stack)
{
  BaseType_t ret = xTaskCreate(Fatigue_Task_Entry,
                               "Fatigue",
                               (configSTACK_DEPTH_TYPE)stack,
                               NULL,
                               (UBaseType_t)prio,
                               &FatigueTaskHandle);
  /* 堆不足时 xTaskCreate 返回 pdFAIL，任务会静默不运行，必须断言拦住 */
  configASSERT(ret == pdPASS);
}

/* ---------------------------------------------------------------------------
 * 任务入口
 * ------------------------------------------------------------------------- */
void Fatigue_Task_Entry(void *argument)
{
  (void)argument;
  /* USER CODE BEGIN Fatigue_Task_Entry_Init */
  /* 任务级初始化：只执行一次 */
  /* USER CODE END Fatigue_Task_Entry_Init */

  for (;;)
  {
    /* USER CODE BEGIN Fatigue_Task_Entry_Loop */
    /* TODO: 增量方差 → 步频/自相关 → 与基线比较 → 输出疲劳等级 */

    vTaskDelay(pdMS_TO_TICKS(10));
    /* USER CODE END Fatigue_Task_Entry_Loop */
  }
}

/* USER CODE END Application */
