AngRelia/Fall-Detection-System/(commit log)

2026-10-13 初始提交：可穿戴跌倒检测与定位告警系统（节点 B 固件）
    节点 B（STM32F103C8T6）主控固件：GPS 定位 + HC-08 蓝牙上报 + 按键/OLED 交互
    + FreeRTOS 多任务骨架，附设计文档与"不依赖 Keil"的验证工具。
    本次完成：
    - GPS（USART1 / PB6-PB7）：NMEA 驱动（循环 DMA + 空闲中断）、RMC/GGA/GSV 解析、
    三页 OLED 接收页（链路/卫星/位置）、语句类型普查、$PCA 配置与语句集自动修复；
    已上板定位成功（FIX、11 颗星、HDOP 2.9、坐标正确）
    - HC-08（USART2 / PA2-PA3）：驱动（空闲中断 + 环形缓冲 + 按行切分）、ble_task
    （AT 探测、BOOT 报文、BLE_Report 单槽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
2026-10-15 HC-08 上板验证通过：手机收到 AT+BOOT 报文（34 字节）
    - 记录首板实测（phone: 汇承 App 已连接、收到 34 字节）
    - 澄清一个易误判现象：HC-08 只在未连接时解析 AT；手机先连上时 AT 会被当数据透传，
    此时 ATOK 为 0 属正常，链路成功的判据是手机收到 BOOT 报文（docs §7.1）
    - OLED 默认屏切到 HC-08 页（OLED_SCREEN_SEL = OLED_SCREEN_HC08）并真编译验证
    Flash 38.03 KB / RAM 18.68 KB
    - README 进度表更新
2026-10-15 HC-08 修两处联调问题：裸命令组帧 + STATE 极性开关
    1) 手机 App 默认不加换行（实测发 5 次 PING 共 20 字节 = 每次 4 字节），
    而驱动只认 LF 行尾 -> 命令永远不完整、手机收不到任何应答。
    修法：HC08_Process 增加「静默判帧」（行内有内容且静默 >=100 ms 即收尾），
    裸命令照样能用；文档同时建议在 App 里勾上「发送新行」。
    2) HC08_IsConnected 增加 HC08_STATE_ACTIVE_HIGH 开关（个别批次模块的连接指示
    可能是低有效）；并说明未接 STATE 脚时屏幕显示 NOT CONN 属正常，不影响收发。
    文档新增 7.2 / 7.3 两节记录实测现象与判读方法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
2026-10-15 GPS 修正"最后已知位置"语义：无效帧不再覆盖，fix_age 只随有效定位刷新
    实测（BLE STAT 报文）发现：
    {"v":0,"lat":0,"lon":0,"hdop":2550,"fix_age":266}
    室内丢星后模块仍以 1 Hz 发 status=V / quality=0 的 RMC/GGA（字段为空、
    hdop 是 25.50 之类占位值），原实现无条件写入位置与 stamp_ms，
    于是"最后已知位置"被冲成 0、fix_age 一直是几百毫秒 —— 与设计意图相反。
    修正：
    - GPS_ParseRMC / GPS_ParseGGA 只在有效定位（status=A / quality>0）时才更新
    位置、时间、海拔、HDOP、卫星数并刷新 stamp_ms；无效帧只更新"当前是否有效"。
    - 新增 GPS_Fix_t.fix_ever：从未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
2026-10-15 节点A发帧修复为严格 100 Hz（含同步文档）+ 菜单与交互设计
    节点A（另仓库 commit ba23cad）：把发帧节拍从主循环搬进 TIM2 中断（200 Hz 解算二分频
    = 严格 10 ms），yaw 归零计算一并搬到打包前；主循环不再参与发帧。原因：原主循环
    "每 2 圈发一帧"实测约 42 Hz 且间隔不匀（磁力计 10 ms 阻塞 + OLED 刷屏），
    而节点B 的 ML 特征假设严格 100 Hz（差分 Jerk 乘 FS、过零率、头尾 0.5 s 切片）。
    节点A 编译链接验证：Flash 38.99 KB / RAM 4.40 KB。
    节点B 本次改动：
    - docs/DIY_IMU接入说明.md §5 重写：记录 100 Hz 是硬约束、42 Hz 的后果、
    以及"为什么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
2026-10-15 菜单/状态总览落地（menu_task + OLED_SCREEN_MENU 四页），一屏看三条链路
    - 新增 MDK-ARM/icode/task/menu_task.c/.h：
    翻页 + 汇总节点A/GPS/BLE/系统快照 → Menu_View_t（双缓冲，读者读不到"写一半"的数据）
    周期 20 ms，栈 192 word，优先级 osPriorityBelowNormal（在 OLED 之上）
    - oled_task.c 新增 OLED_SCREEN_MENU（=4）并设为默认屏，画四页：
    1/4 总览（NODE-A 帧率/OK·LOST、GPS FIX/SAT、BLE CONN/TX、HEAP、UPTIME）
    2/4 节点A（RATE/OK/CRC/RSY/DROP/BUF/STATE）
    3/4 GPS（LINK/RX/SEN/CSE/FIX/Q/SAT/VW/MX/LAT/LON）
    4/4 BLE（LINK/TXB/RXB/ATOK/ATERR/SEND/DROP/LAST）
    OLED_ShowChars 的编译守卫扩展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
2026-10-15 修复主机端 OLED 换页残留：菜单页补清屏 + 页内变长状态字改定长 + IMU 页补清屏
    现象（实测反馈）：主机端（节点B）切换页面时，各页内容互相叠在一起。
    根因（同一类问题的第三次出现）：
    1) 新写的 OLED_Menu_Page() 忘了"换页清屏"——四页每行字符串长度不同
    （标题 9~12 字符、LOST/OK、CONN/NOT CONN），上一页没被覆盖的字符留在屏上；
    2) 菜单页内还有两处"同一页内长度会变"的状态字：
    "LOST"/"OK"（4 vs 2） -> 改 "LOST"/"OK "
    "CONN"/"NOT CONN"（4 vs 8）-> 改 "CONN "/"NOT CONN"
    3) IMU 页的 3 s 三页轮换也没有清屏（潜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
2026-10-15 菜单节点A页新增 RXB（原始字节数）：用于区分"没字节"与"帧解不出"
    背景：反馈 DIY IMU 链路收不到数据。核实结论：
    - 节点A 发送路径完好：DMA1_Channel7_IRQHandler → HAL_DMA_IRQHandler →
    HAL_UART_TxCpltCallback → Proto_TxComplete 链路完整；proto.c 无宏门控；
    NVIC 优先级 TIM2=1、DMA1_CH6/CH7=0（TC 中断可抢占 TIM2，不会饿死）；
    且 main.h 恢复后节点A 的 Flash 占用与事故前完全一致（39,924 B），
    说明恢复是行为等价的（编译期被"关掉"的代码会改变体积）。
    - 主机端：IMU_Recv_GetSnapshot() 是临界区内纯拷贝、无副作用，菜单 20 ms 调一次无害；
    m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
2026-10-15 文档：记录"主机收不到 IMU 数据"的真实原因（烧写完没复位运行）
    2026-10-16 实测：主机收不到节点A 数据，**手动复位节点A 后立刻正常**。
    根因不是链路或代码，而是 Keil 下载后没有自动复位运行（停在旧状态/未启动）。
    - docs/DIY_IMU接入说明.md §7 重写排查顺序：
    · 新增第 0 步「烧写完有没有真的跑起来」——给出 Keil 勾选 Reset and Run 的路径，
    以及"看一眼节点A 自己的 OLED 是否在动"这个最省事的活着判据
    · 新增"先用主机端数字分层判断"表（菜单 2/4 页的 RXB / OK / CRC）
    · 补充说明主机端有自愈（IMU_LINK_TIMEOUT_MS 超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
